ffich/MercurySystem/20_Output/30_Documentation/10_Datasheet/SB330_TemperatureBoard/Images/SB330_Hardware.png

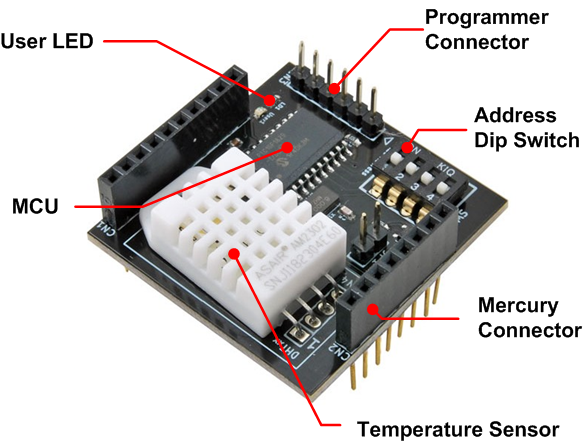
20_Output/30_Documentation/10_Datasheet/SB330_TemperatureBoard/Images/SB330_Hardware.png
