ffich/MercurySystem/10_Input/10_Specifiche/Mercury_MB310_ModemBt/Mercury_MB310_ModemBt_SpecificheTecniche.docx

Mercury System

Sistema modulare per applicazioni IoT

Modem Bluetooth (MB310)

Nome Cliente | Progetto | Major Rev | Minor Rev | Data
Internal | Mercury System – MB310 | 1 | 0 | 04/01/2017

Revisioni
Autore | Data | Major | Minor | Descrizione
Francesco Ficili | 04/01/2017 | 1 | 0 | Prima release.

# 1. Introduzione

Questo documento ha lo scopo di descrivere in dettaglio le specifiche relative alla scheda elettronica Mercury Modem BT, che costituisce una delle schede modem del “Mercury System”.

# 2. Schema a blocchi Hardware Base Board

In figura 2.1 è riportato lo schema a blocchi di principio del sistema. Il cuore del sistema è un modulo BT HC05.

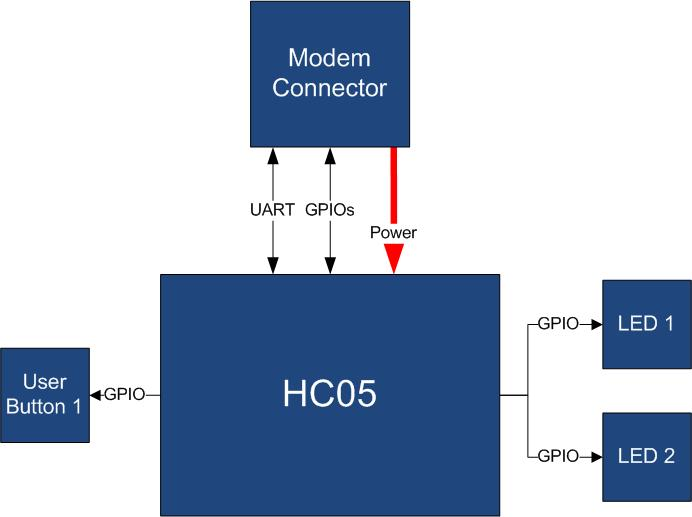
[picture p11: figure]

Figura 2.1 – Schema a blocchi hardware

I collegamenti in nero indicano collegamenti di segnale, i collegamenti in rosso indicano collegamenti di potenza.

Il modulo si interfaccia alla base board tramite il modem connector Mercury, che trasporta le linee di comunicazione e di alimentazione per il modem stesso.

La scheda è inoltre dotata di un pulsante collegato al pin KeyBt del modulo (con apposita resistenza di pull-up) e di due led di indicazione (pair e working).

# 3. Requisiti Hardware

Il sistema deve rispettare i requisiti hardware riportati in tabella 3.1

Requisito | Descrizione
MB310_HW_010 | Il connettore per la scheda modem da utilizzare è una strip a passo 2mm, 10x2.

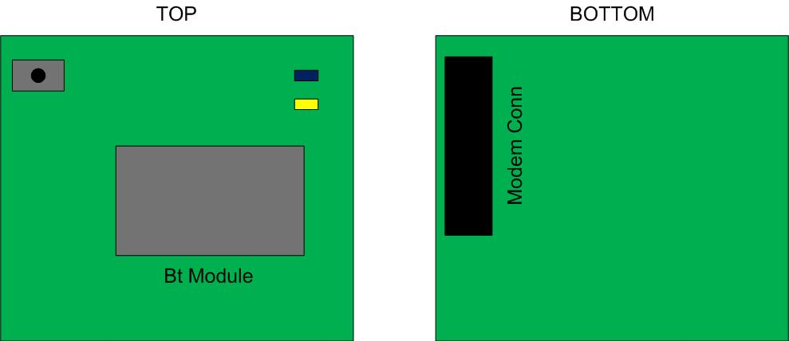
[picture p12: figure]

MB310_HW_020 | Il layout connettori della scheda è rappresentato nella figura in basso:
BB110_HW_030 | Le dimensioni indicative della scheda dovranno essere 38x32mm.

Tabell 3.1 – Requisiti Hardware

# 4. Power/Voltage Budget

In tabella 4.1 è riportato il voltage budget del sistema.

Componente | Operating Voltage Range [V]
Bt Module | 3.1 – 4.2

Tabella 4.1 – Voltage budget

In tabella 4.2 è riportato il power budget del sistema.

Componente | Low Power (e.g Sleep) | Typ. Power Cons. | Peak Power Cons.
Bt Module | 8mA | 8mA | 40mA

Tabella 4.2 – Power budget

Mercury System – Specifiche Tecniche
