ffich/MercurySystem/10_Input/10_Specifiche/Mercury_MB810_MbProtoA/Mercury_MB810_ModemProto_SpecificheTecniche.docx

Mercury System

Sistema modulare per applicazioni IoT

Modem Proto (MB810)

Nome Cliente | Progetto | Major Rev | Minor Rev | Data
Internal | Mercury System – MB810 | 1 | 0 | 06/01/2017

Revisioni
Autore | Data | Major | Minor | Descrizione
Francesco Ficili | 06/01/2017 | 1 | 0 | Prima release.

# 1. Introduzione

Questo documento ha lo scopo di descrivere in dettaglio le specifiche relative alla scheda elettronica Mercury Modem Proto, che costituisce una delle schede modem del “Mercury System”.

# 2. Schema a blocchi Hardware Base Board

In figura 2.1 è riportato lo schema a blocchi di principio del sistema.

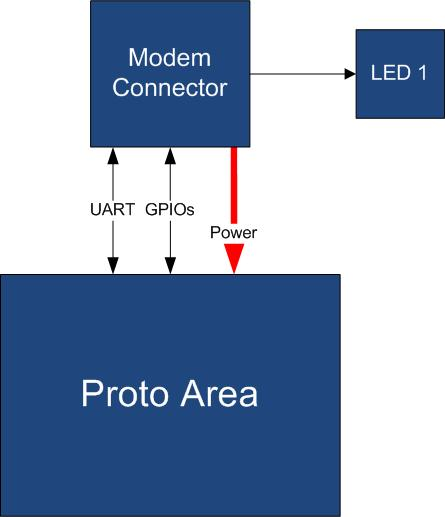
[picture p13: figure]

Figura 2.1 – Schema a blocchi hardware

I collegamenti in nero indicano collegamenti di segnale, i collegamenti in rosso indicano collegamenti di potenza.

Il modulo si interfaccia alla base board tramite il modem connector Mercury, che trasporta le linee di comunicazione e di alimentazione per il modem stesso.

# 3. Requisiti Hardware

Il sistema deve rispettare i requisiti hardware riportati in tabella 3.1

Requisito | Descrizione
MB810_HW_010 | Il connettore per la scheda modem da utilizzare è una strip a passo 2mm, 10x2.

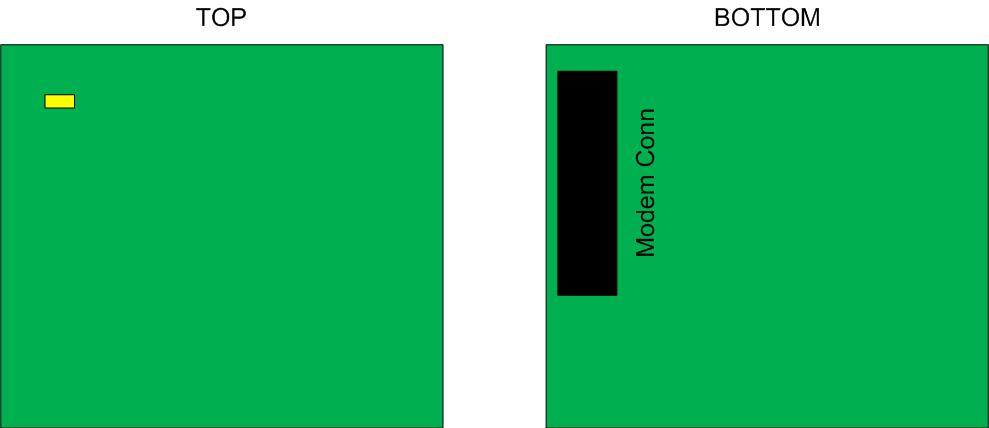
[picture p14: figure]

MB810_HW_020 | Il layout connettori della scheda è rappresentato nella figura in basso:
MB810_HW_030 | Le dimensioni indicative della scheda dovranno essere 38x32mm.

Tabell 3.1 – Requisiti Hardware

Mercury System – Specifiche Tecniche
