ffich/MercurySystem/10_Input/10_Specifiche/Mercury_SB110_RelayBoard/Mercury_SB110_RelayBoard_SpecificheTecniche.docx

Mercury System

Sistema modulare per applicazioni IoT

Relay Board (SB110)

Nome Cliente | Progetto | Major Rev | Minor Rev | Data
Internal | Mercury System – SB110 | 1 | 2 | 27/12/2015

Revisioni
Autore | Data | Major | Minor | Descrizione
Francesco Ficili | 27/12/2015 | 1 | 0 | Prima release.
Francesco Ficili | 29/05/2016 | 1 | 1 | Reworked.
Francesco Ficili | 31/12/2017 | 1 | 2 | Aggiunti requisiti SW e set di comandi.
Francesco Ficili | 12/01/2019 | 1 | 3 | Aggiunta variante con singolo relè da 10A.

# 1. Introduzione

Questo documento ha lo scopo di descrivere in dettaglio le specifiche relative alla scheda elettronica Mercury Relay Board, che costituisce una delle schede slave del “Mercury System”.

# 2. Schema a blocchi Hardware Relay Board

In figura 2.1 è riportato lo schema a blocchi di principio del sistema. Il cuore del sistema è un microcontrollore PIC16F1825, RISC a 8-bit, prodotto dalla Microchip Technology.

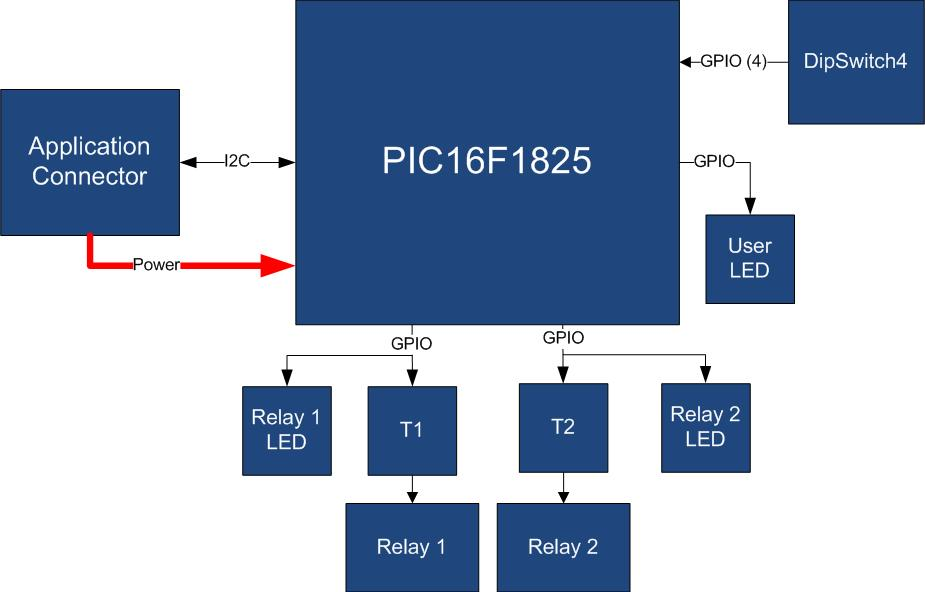
[picture p17: figure]

Figura 2.1 – Schema a blocchi hardware

I collegamenti in nero indicano collegamenti di segnale, i collegamenti in rosso indicano collegamenti di potenza.

La MCU utilizzata ha le seguenti caratteristiche (vedi Tabella 2.1).

Parameter Name | Value
Program Memory Type | Flash
Program Memory (KB) | 14
CPU Speed (MIPS) | 8
RAM Bytes | 1,024
Data EEPROM (bytes) | 256
Digital Communication Peripherals | 1-UART, 1-A/E/USART, 1-SPI, 1-I2C1-MSSP(SPI/I2C)
Capture/Compare/PWM Peripherals | 2 CCP, 2 ECCP
Timers | 4 x 8-bit, 1 x 16-bit
ADC | 8 ch, 10-bit
Comparators | 2
Temperature Range (C) | -40 to 125
Operating Voltage Range (V) | 1.8 to 5.5
Pin Count | 14
XLP | Yes
Cap Touch Channels | 12

Tabell 2.1 – Caratteristiche Hardware PIC16F1825

Il microcontrollore principale si interfaccia alla Mercury base board tramite l’application connector. Da questo connettore preleva l’alimentazione e si interfaccia al bus I2C, in modo da poter comunicare con la MCU della base board. La MCU è collegata tramite 4 linee di I/O ad un dipswitch a 4 posizioni, che permette di impostare l’indirizzo del nodo slave (nel caso di utilizzo di più di un nodo slave sulla rete I2C).

Il microcontrollore si interfaccia inoltre con 2 relè attraverso due linee di I/O.

La scheda dispone di una memoria non volatile EEPROM interna, per lo stoccaggio di parametri di configurazione.

# 3. Requisiti Hardware

Il sistema deve rispettare i requisiti hardware riportati in tabella 3.1

Requisito | Descrizione
SB110_HW_010 | Le uscite dei due relè devono essere implementate tramite due connettori jst a 3 poli (possibile variante con due morsettiere a 3 poli passo 2,54mm).
SB110_HW_020 | Il connettore per la scheda application è costituito da due connettori singoli a passo 2,54mm, 10x1 e 8x1 disposti ai lati del PCB.

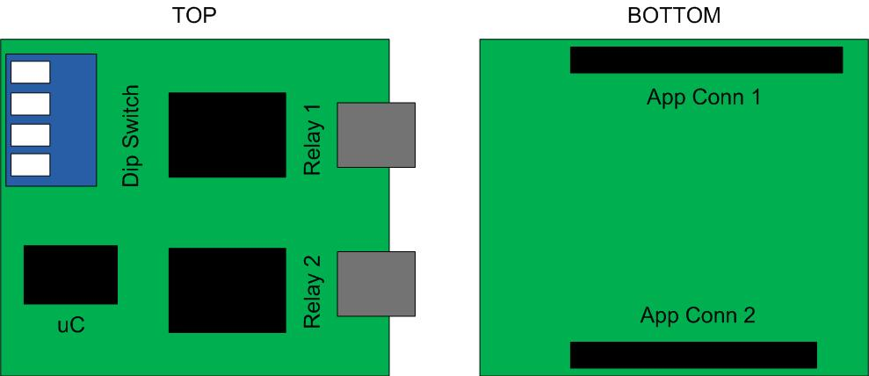
[picture p18: figure]

SB110_HW_030 | Il layout della scheda è rappresentato nella figura in basso:
SB110_HW_040 | Le dimensioni indicative della scheda dovranno essere 38x40mm.

Tabell 3.1 – Requisiti Hardware

# 4. Requisiti Software

Il sistema deve rispettare i requisiti funzionali riportati in tabella 4.1

Requisito | Descrizione
SB110_SW_010 | Il sw della scheda deve implementare il set di comandi standard per gli slave del sistema Mercury.
SB110_SW_020 | Il sw della scheda deve implementare il set di comandi dedicato, riportato al paragrafo 5.
SB110_SW_030 | Il sistema deve gestire il SW watchdog con periodo di 2s e rate di refresh di 100ms.

Tabella 4.1 – Requisiti Software

# 5. Command Set

Il sistema deve implementare il seguente set di comandi (tabella 5.1), specifico per la SB110.

Codice | Nome Cmd | Parametri | Descrizione
0x50 | Set relay status | Relay Sts (1 byte) | Setta lo stato dei relè della scheda. Lo stato è mappato come bitfield nel parametro Relay Sts (ogni bit rappresenta un relè, solo i primi due bit sono usati).
0x51 | Impulse relay 1 Seconds | Impulse len (2 byte) | Genera un impulso di durata pari al parametro per il relè 1 (il parametro Impulse len è in secondi).
0x52 | Impulse relay 2 Seconds | Impulse len (2 byte) | Genera un impulso di durata pari al parametro per il relè 2 (il parametro Impulse len è in secondi).
0x53 | Impulse both relay Seconds | Impulse len (2 byte) | Genera un impulso di durata pari al parametro per entrambi relè (il parametro Impulse len è in secondi).
0x60 | Request relay status | Nessuno | Richiede lo stato dei relè (questo comando prepara un byte che rappresenta lo stato dei relè come bitfield).

Tabella 5.1 – Command Set

# 6. Power/Voltage Budget

In tabella 6.1 è riportato il voltage budget del sistema:

Componente | Operating Voltage Range [V]
uC | 2.0 – 3.6 (regolato a 3.0)

Tabella 6.1 – Voltage budget

In tabella 6.2 è riportato il power budget del sistema:

Componente | Low Power (e.g Sleep) | Typ. Power Cons. | Peak Power Cons.
uC | 100nA | 10uA | 1mA

Tabella 6.2 – Power budget

# 7. Variante SB111

La SB111 è una variante del modello SB110 con singolo relè da 10A. Il modello di relè scelto per questa variante è il modello OMRON G5LA-14 da 5VDC. Anche la morsettiera dei contatti di uscita è da sostituire con un modello a passo 5,12mm.

Mercury System – Specifiche Tecniche
