ffich/MercurySystem/10_Input/10_Specifiche/Mercury_SB320_InfraredBoard/Mercury_SB320_InfraredBoard_SpecificheTecniche.docx

Mercury System

Sistema modulare per applicazioni IoT

Infrared Board (SB320)

Nome Cliente | Progetto | Major Rev | Minor Rev | Data
Internal | Mercury System – SB320 | 1 | 2 | 28/12/2015

Revisioni
Autore | Data | Major | Minor | Descrizione
Francesco Ficili | 28/12/2015 | 1 | 0 | Prima release.
Francesco Ficili | 29/05/2016 | 1 | 1 | Reworked.
Francesco Ficili | 03/01/2018 | 1 | 2 | Aggiunti requisiti SW e set di comandi.

# 1. Introduzione

Questo documento ha lo scopo di descrivere in dettaglio le specifiche relative alla scheda elettronica Mercury Infrared Board, che costituisce una delle schede slave del “Mercury System”.

# 2. Schema a blocchi Hardware Infrared Board

In figura 2.1 è riportato lo schema a blocchi di principio del sistema. Il cuore del sistema è un microcontrollore PIC16F1825, RISC a 8-bit, prodotto dalla Microchip Technology.

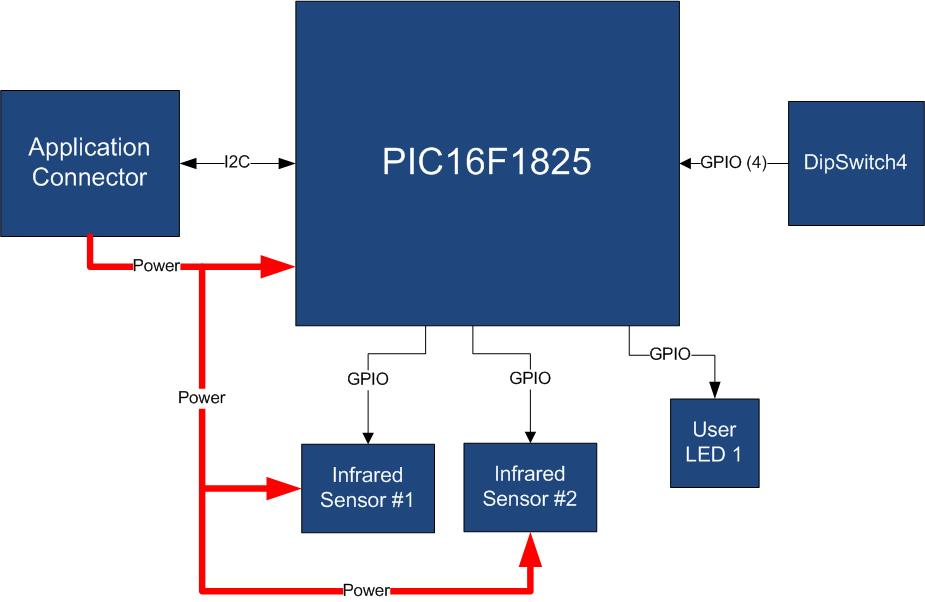
[picture p27: figure]

Figura 2.1 – Schema a blocchi hardware

I collegamenti in nero indicano collegamenti di segnale, i collegamenti in rosso indicano collegamenti di potenza.

La MCU utilizzata ha le seguenti caratteristiche (vedi Tabella 2.1).

Parameter Name | Value
Program Memory Type | Flash
Program Memory (KB) | 14
CPU Speed (MIPS) | 8
RAM Bytes | 1,024
Data EEPROM (bytes) | 256
Digital Communication Peripherals | 1-UART, 1-A/E/USART, 1-SPI, 1-I2C1-MSSP(SPI/I2C)
Capture/Compare/PWM Peripherals | 2 CCP, 2 ECCP
Timers | 4 x 8-bit, 1 x 16-bit
ADC | 8 ch, 10-bit
Comparators | 2
Temperature Range (C) | -40 to 125
Operating Voltage Range (V) | 1.8 to 5.5
Pin Count | 14
XLP | Yes
Cap Touch Channels | 12

Tabell 2.1 – Caratteristiche Hardware PIC16F1825

Il microcontrollore principale si interfaccia alla Mercury base board tramite l’application connector. Da questo connettore preleva l’alimentazione e si interfaccia al bus I2C, in modo da poter comunicare con la MCU della base board. La MCU è collegata tramite 4 linee di I/O ad un dipswitch a 4 posizioni, che permette di impostare l’indirizzo del nodo slave (nel caso di utilizzo di più di un nodo slave sulla rete I2C).

La scheda dispone di due connettori a 2 poli per l’interfacciamento con altrettanti sensori di distanta all’infrarosso, modello 8218-GP2Y0D810ZOF o 7300-GP2Y0D805PCB.

La scheda dispone di una memoria non volatile EEPROM interna, per lo stoccaggio di parametri di configurazione.

# 3. Requisiti Hardware

Il sistema deve rispettare i requisiti hardware riportati in tabella 3.1

Requisito | Descrizione
SB320_HW_010 | I connettori per i sensori all’infrarosso devono essere due coppie di strip femmina a 3 poli con inclinazione a 90°.
SB320_HW_020 | Il connettore per la scheda application è costituito da due connettori singoli a passo 2,54mm, 10x1 e 8x1 disposti ai lati del PCB.

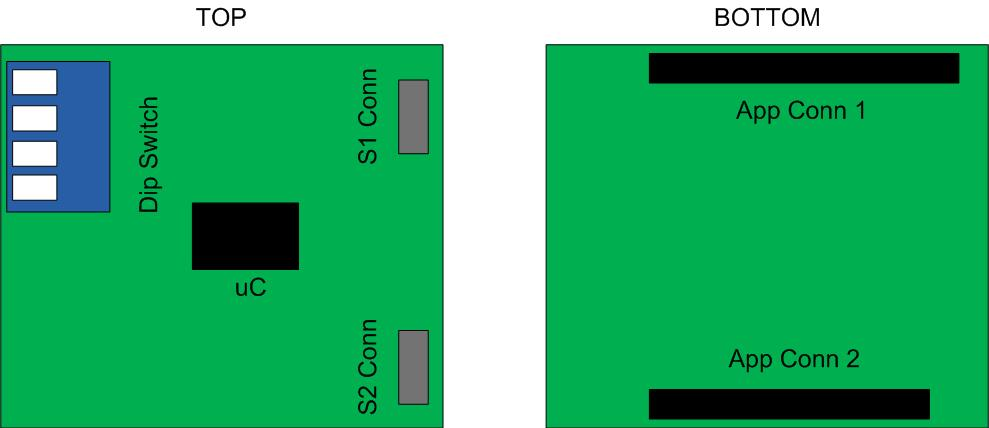
[picture p28: figure]

SB320_HW_030 | Il layout della scheda è rappresentato nella figura in basso:
SB320_HW_040 | Le dimensioni indicative della scheda dovranno essere 38x40mm.

Tabell 3.1 – Requisiti Hardware

# 4. Requisiti Software

Il sistema deve rispettare i requisiti funzionali riportati in tabella 4.1

Requisito | Descrizione
SB320_SW_010 | Il sw della scheda deve implementare il set di comandi standard per gli slave del sistema Mercury.
SB320_SW_020 | Il sw della scheda deve implementare il set di comandi dedicato, riportato al paragrafo 5.
SB320_SW_030 | Il sistema deve gestire il SW watchdog con periodo di 2s e rate di refresh di 100ms.

Tabell 4.1 – Requisiti Funzionali

# 5. Command Set

Il sistema deve implementare il seguente set di comandi (tabella 5.1), specifico per la SB110.

Codice | Nome Cmd | Parametri | Descrizione
0x60 | Request IR Sensors Status | Nessuno | Richiede lo stato dei due sensori IR. Questo comando prepara un byte che rappresenta lo stato dei due sensori come bitfield (solo i primi due bit sono utilizati).
0x61 | Request IR Sensors Status ASCII | Nessuno | Richiede la distanza in centimetri in formato ASCII (questo comando prepara due byte che rappresentano lo stato dei due sensori IR in formato ASCII).

Tabella 5.1 – Command Set

# 6. Power/Voltage Budget

In tabella 6.1 è riportato il voltage budget del sistema:

Componente | Operating Voltage Range [V]
uC | 2.0 – 3.6 (regolato a 3.0)
Infrared Sensor | 2,7 – 6,2 (regolato a 3.0)

Tabella 6.1 – Voltage budget

In tabella 6.2 è riportato il power budget del sistema:

Componente | Low Power (e.g Sleep) | Typ. Power Cons. | Peak Power Cons.
uC | 100nA | 10uA | 1mA
Infrared Sensor | 5mA | 5mA | 5mA

Tabella 6.2 – Power budget

Mercury System – Specifiche Tecniche
