ffich/MercurySystem/20_Output/30_Documentation/40_ProductPages/EB210_ExpansionLCD16x2/MS_EB210_ProductPage.docx

# 1. Mercury System EB210 – LCD 16x2 Expansion Board

The EB210 is a Mercury System expansion board with integrated alphanumeric 16x2 display. The board allows the classic planar expansion offered by Mercury System expansion board, and at the same time provides a way to build a simple User Interface. Figure 1 shows the EB210 block diagram. The heart of the system is a PIC16F1829 8-bit RISC microcontroller, produced by Microchip Technology Inc.

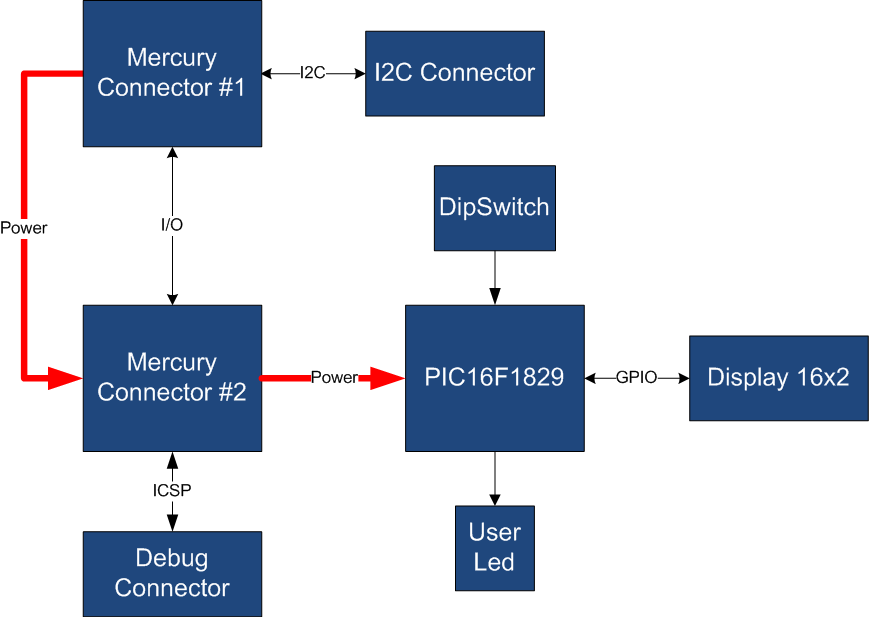
[picture p59: figure]

Figure 1 - Block Diagram

The main characteristics of the employed MCU are resumed in Table 1:

Table 1 - MCU characteristics

Parameter Name | Description
Program Memory Type | Flash
Program Memory (KB) | 14
CPU Speed (MIPS) | 8
RAM Bytes | 1,024
Data EEPROM (bytes) | 256
Digital Communication Peripherals | 1-UART, 1-A/E/USART, 1-SPI, 1-I2C1-MSSP(SPI/I2C)
Capture/Compare/PWM Peripherals | 2 CCP, 2 ECCP
Timers | 4 x 8-bit, 1 x 16-bit
ADC | 12 ch, 10-bit
Comparators | 2
Temperature Range (C) | -40 to 125
Operating Voltage Range (V) | 1.8 to 5.5
Pin Count | 20
XLP | Yes

The EB210 is connected to the BB by means of I2C bus. The address of the board could be dynamically set by means of a 4 positions dip switch, allowing up to 15 address values (address 0x00 is reserved for I2C general call broadcast addressing scheme).

Table 2 resumes the EB210 board main characteristics:

Table 2 – Board Characteristics

Parameter | Description | Notes
Board Type | Expansion Board (EB)
Supported Bus | I2C
Addressing | Dip Switch 4
Peripheral Description | Alphanumeric 16x2 LCD Display

Figure 2 depicts the most important components of the board:

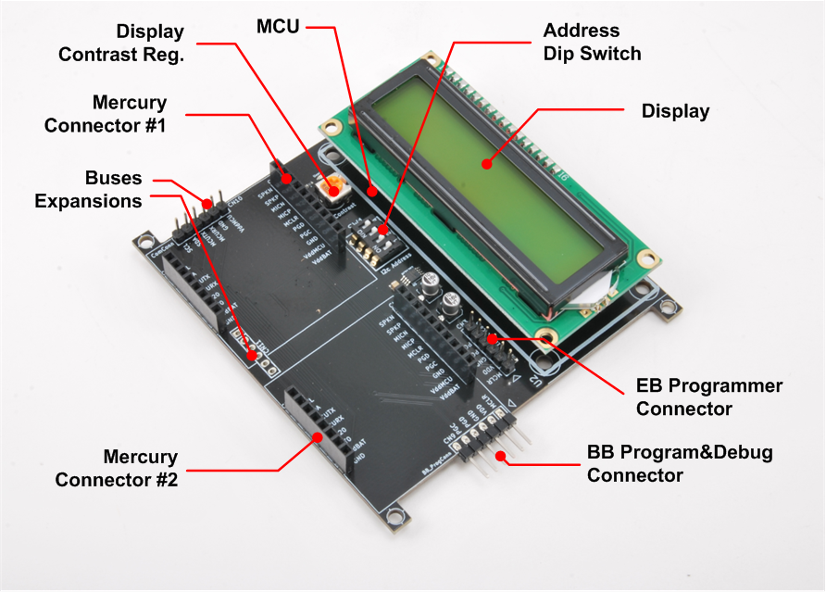
[picture p60: figure]

Figure 2 - Hardware Highlight

Table 3 provides a description of board’s main components:

Table 3 – Hardware characteristics

Name | Description
Mercury Connectors #1 and #2 | Mercury connector used to interface the board with the others MS boards.
Address Dip Switch | Dip Switch to set the address of the board within the Mercury System.
MCU | PIC16F1829 main controller board.
EB Programmer Connector | PicKit 3 Microchip Programmer/debugger connector. It is directly connected to the EB (Expansion Board) MCU debug port, in order to allow advanced debugging and programming features, if needed.
BB Program&Debug Connector | PicKit 3 Microchip Programmer/debugger connector. It is directly connected to the BB (Base Board) MCU debug port, in order to allow advanced debugging and programming features, if needed.
Display | 16x2 Alphanumeric LCD Display.
Display Contrast Reg. | Potentiometer for display contrast regulation.
Buses Expansion | Expansions connectors that carry power as well as I2C and UART connection.
