ffich/MercurySystem/10_Input/10_Specifiche/Mercury_System/MERCURY_Microcontroller_BoardCrossReference.xlsx

Mercury Board | Description | Microcontroller
BB110 | Main Board | PIC18F46J50
SB110 | Relay Board | PIC16F1825
SB120 | Neopixel Board | PIC16F1829
SB130 | Servo Board | PIC16F1829
SB140 | HSD Board | PIC16F1829
SB310 | Ultrasonic Board | PIC16F1829
SB320 | Infrared Board | PIC16F1825
SB330 | Temperature Board | PIC16F1829
SB340 | Accel Board | PIC16F1829
SB810 | Proto Board | PIC16F1829
EB210 | Expansion LCD 16x2 Board | PIC16F1829
MB210, MB310, MB810, EB110, EB111 | Modems and generic expansions | No Micro
