ffich/MercurySystem/20_Output/20_SwProjects/10_trunk/10_BaseBoards/Bootloader/BootFwk/BootOptions.docx

Bootloader Options

XC8 Linker\Memory Model --> ROM Ranges: default,-0-1FFF,-2006-2007,-2016-2017,-EFFF-FFFF

XC8 Linker\Additional Options --> CodeOffset: 0x2000

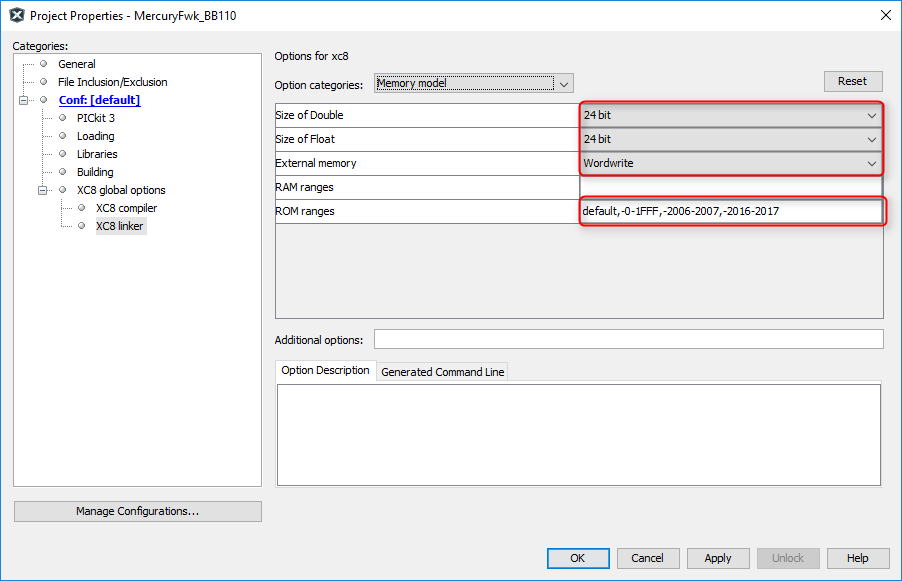
[picture p88: figure]
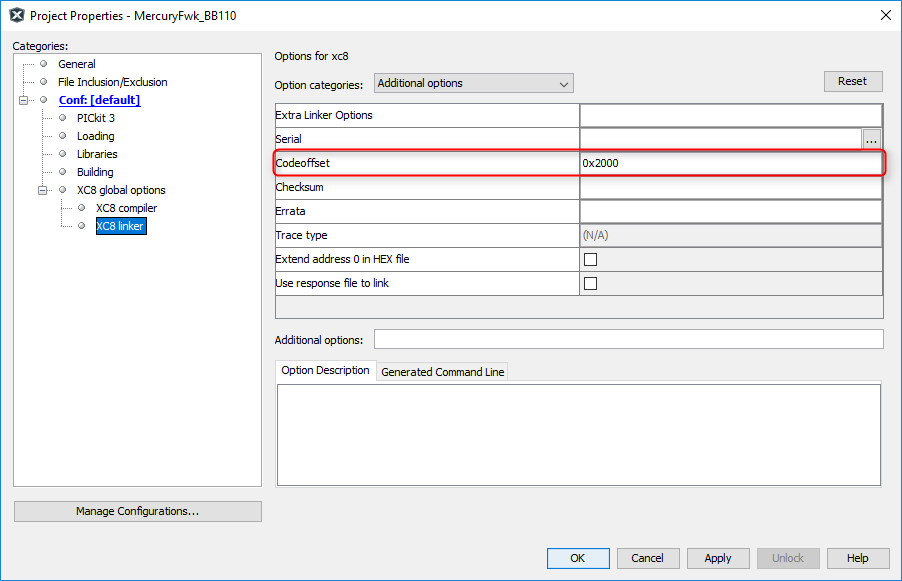
[picture p89: figure]
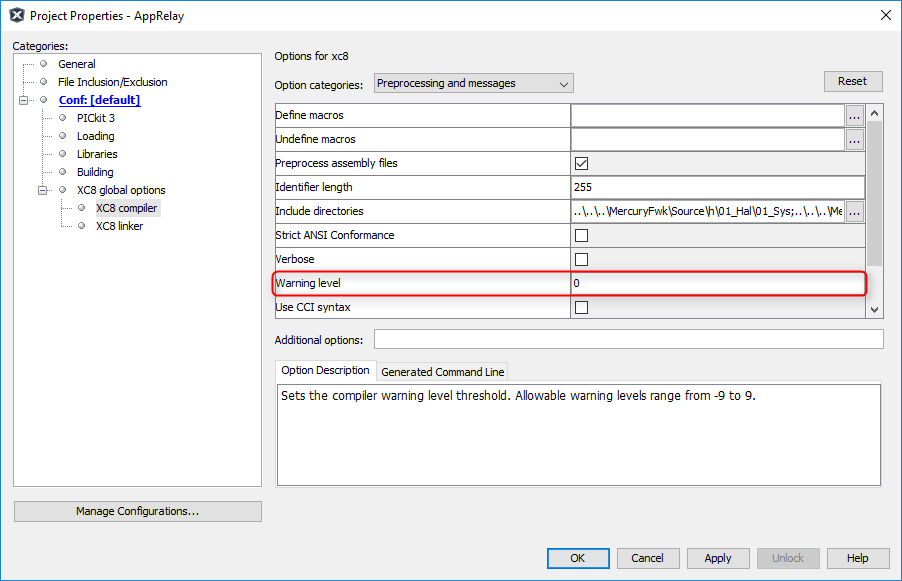
[picture p90: figure]
