ffich/MercurySystem/10_Input/10_Specifiche/Mercury_BB110_BaseBoardModelA/Schemi a blocchi/LayoutExpansionBoard - 4.jpg

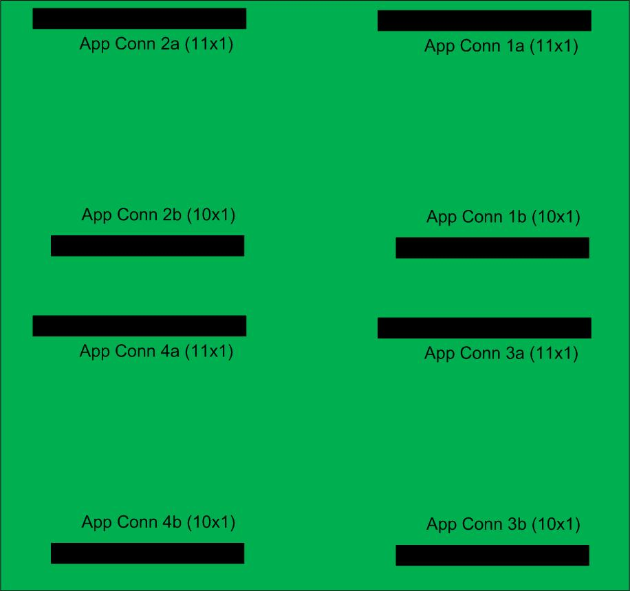
10_Input/10_Specifiche/Mercury_BB110_BaseBoardModelA/Schemi a blocchi/LayoutExpansionBoard - 4.jpg
