ffich/MercurySystem/10_Input/10_Specifiche/Mercury_MB210_ModemWiFi/Schemi a blocchi/ModemConnector.jpg

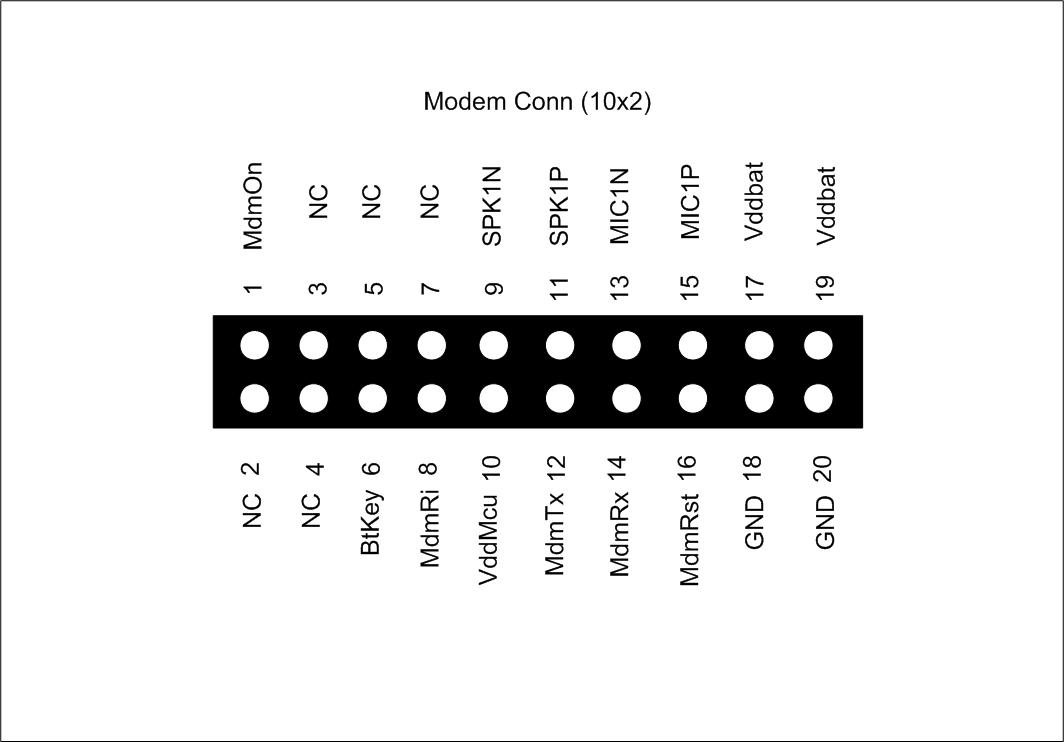
10_Input/10_Specifiche/Mercury_MB210_ModemWiFi/Schemi a blocchi/ModemConnector.jpg
