ffich/MercurySystem/10_Input/10_Specifiche/Mercury_SB330_TemperatureBoard/Schemi a blocchi/MsgTempHum.jpg

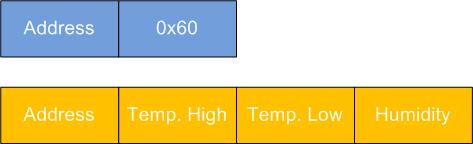
10_Input/10_Specifiche/Mercury_SB330_TemperatureBoard/Schemi a blocchi/MsgTempHum.jpg
