ffich/MercurySystem/10_Input/10_Specifiche/Mercury_System/Immagini/Esempio_BaseBoard.jpg

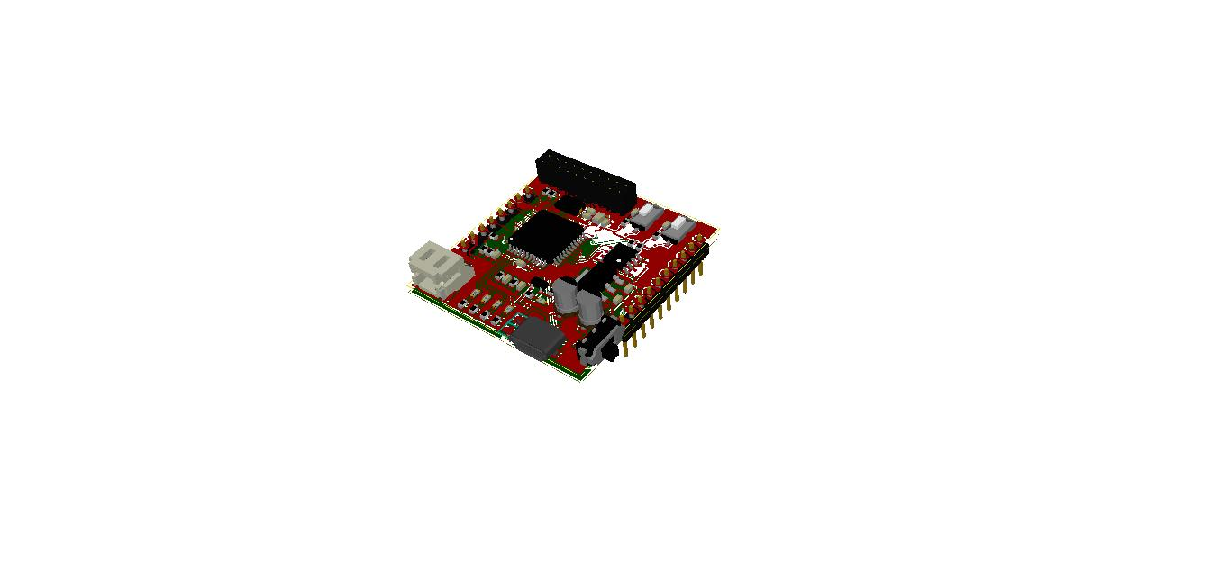
10_Input/10_Specifiche/Mercury_System/Immagini/Esempio_BaseBoard.jpg
