ffich/MercurySystem/20_Output/30_Documentation/10_Datasheet/BB110_BaseBoardPic18F/Images/BB110_3_main-500x500.jpg

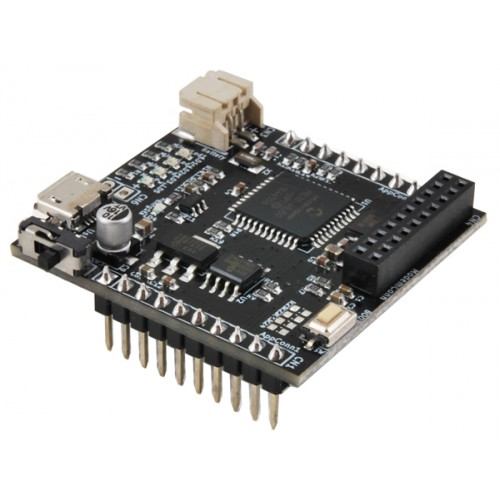
20_Output/30_Documentation/10_Datasheet/BB110_BaseBoardPic18F/Images/BB110_3_main-500x500.jpg
