ffich/MercurySystem/20_Output/30_Documentation/10_Datasheet/BB110_BaseBoardPic18F/Images/BB110_ModemConn.png

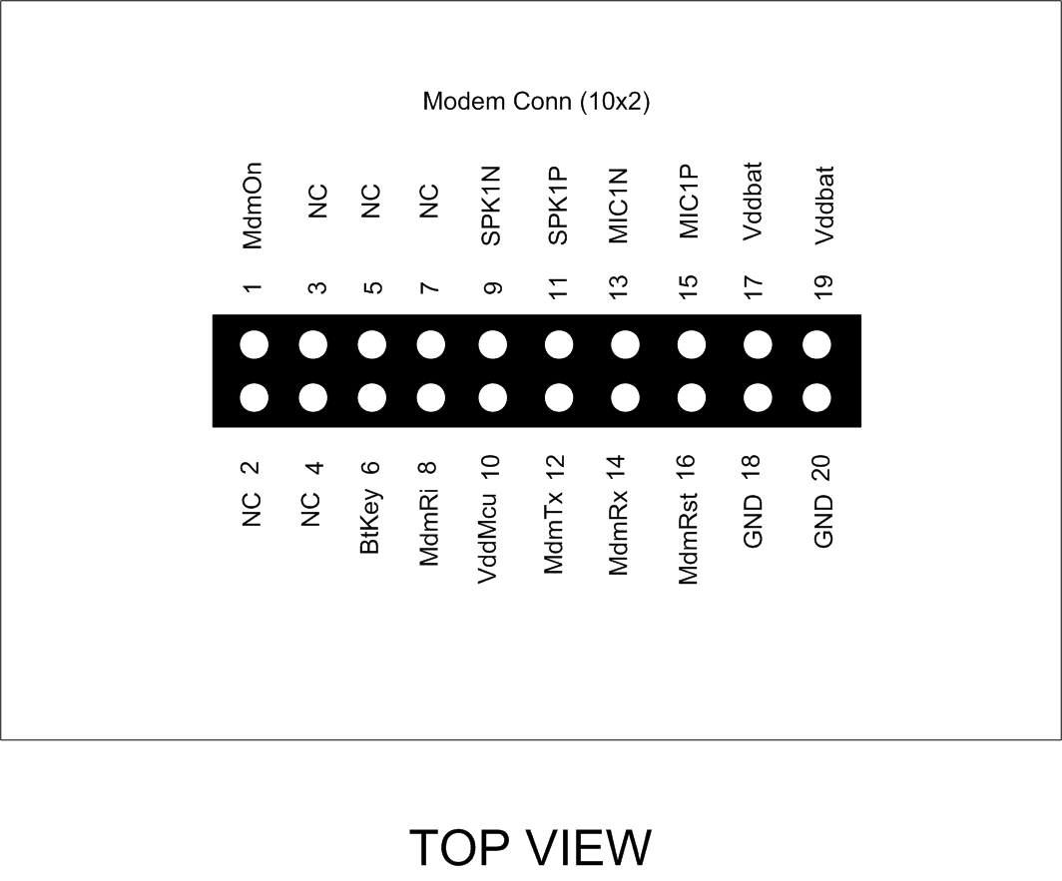
20_Output/30_Documentation/10_Datasheet/BB110_BaseBoardPic18F/Images/BB110_ModemConn.png
