ffich/MercurySystem/20_Output/30_Documentation/10_Datasheet/BL810_BrainlessProto/Images/front.png

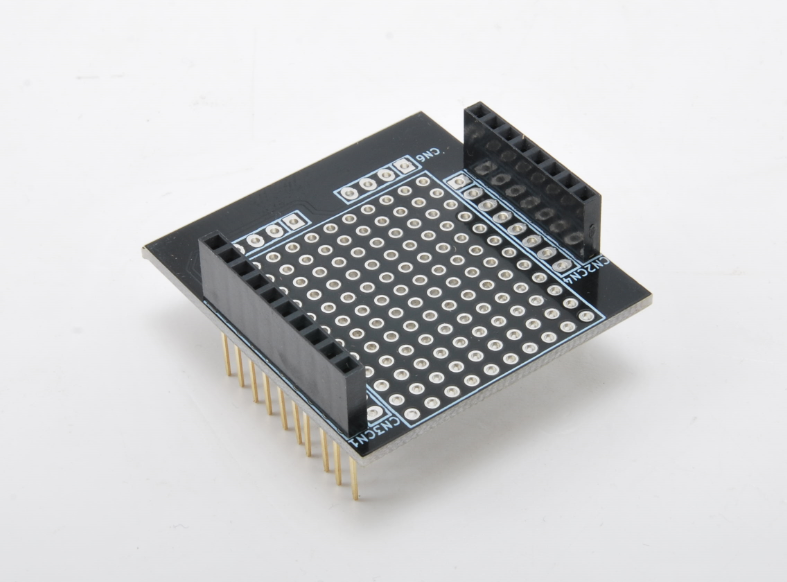
20_Output/30_Documentation/10_Datasheet/BL810_BrainlessProto/Images/front.png
