ffich/MercurySystem/20_Output/30_Documentation/10_Datasheet/EB110_ExpansionDual/Images/EB110_4_main-500x500.jpg

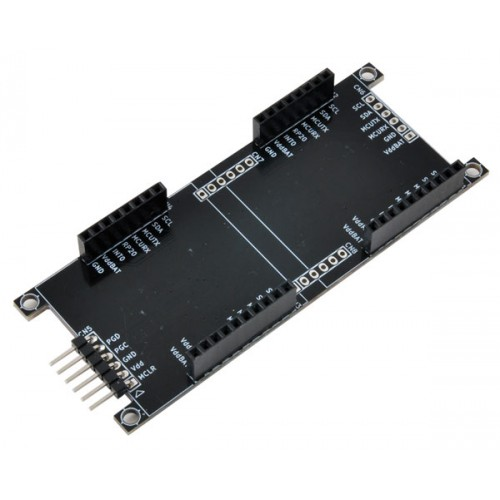
20_Output/30_Documentation/10_Datasheet/EB110_ExpansionDual/Images/EB110_4_main-500x500.jpg
