ffich/MercurySystem/20_Output/30_Documentation/10_Datasheet/EB110_ExpansionDual/Images/EB110_BBProgConn.png

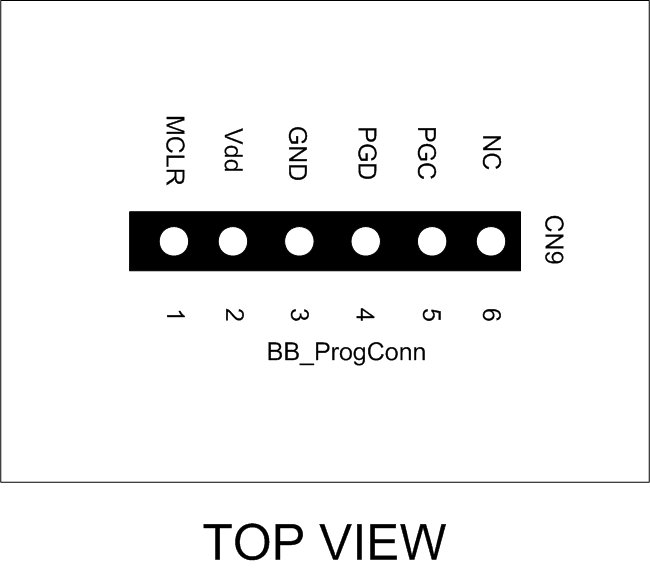
20_Output/30_Documentation/10_Datasheet/EB110_ExpansionDual/Images/EB110_BBProgConn.png
