ffich/MercurySystem/20_Output/30_Documentation/10_Datasheet/EB111_ExpansionQuad/Images/EB111_Front.png

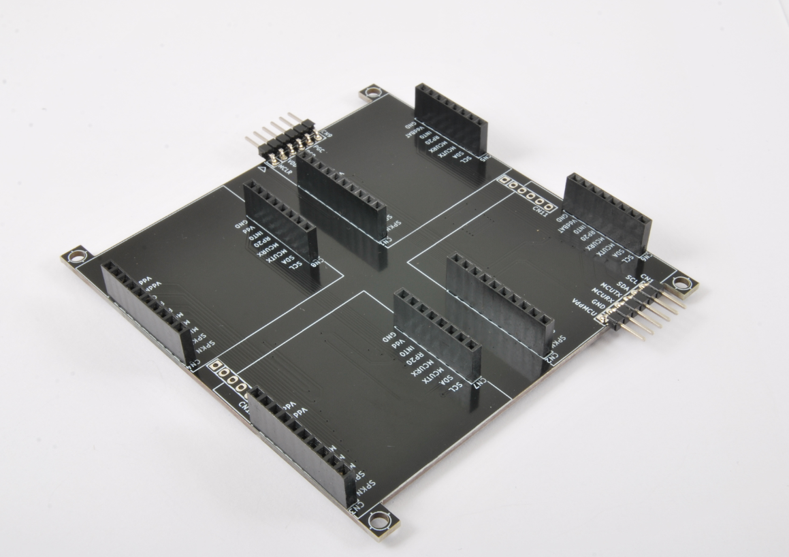
20_Output/30_Documentation/10_Datasheet/EB111_ExpansionQuad/Images/EB111_Front.png
