ffich/MercurySystem/20_Output/30_Documentation/10_Datasheet/EB111_ExpansionQuad/Images/EB111_main-228x228.jpg

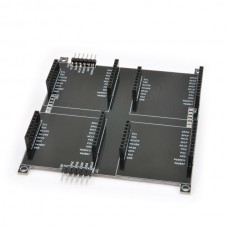
20_Output/30_Documentation/10_Datasheet/EB111_ExpansionQuad/Images/EB111_main-228x228.jpg
