ffich/MercurySystem/20_Output/30_Documentation/10_Datasheet/EB111_ExpansionQuad/Images/HW.png

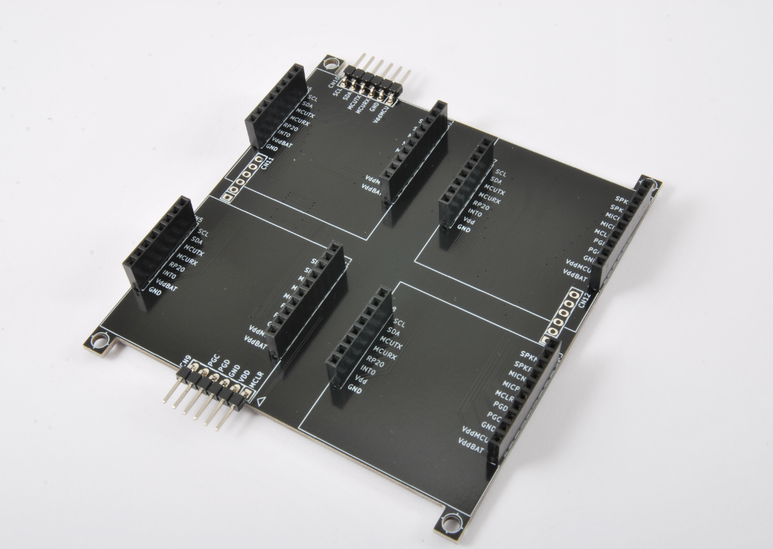
20_Output/30_Documentation/10_Datasheet/EB111_ExpansionQuad/Images/HW.png
