ffich/MercurySystem/20_Output/30_Documentation/10_Datasheet/EB210_ExpansionLCD16x2/Images/EB210-2_main-228x228.jpg

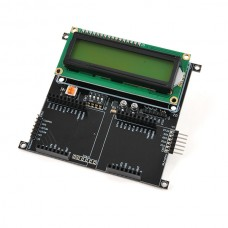
20_Output/30_Documentation/10_Datasheet/EB210_ExpansionLCD16x2/Images/EB210-2_main-228x228.jpg
