ffich/MercurySystem/20_Output/30_Documentation/10_Datasheet/EB210_ExpansionLCD16x2/Images/EB210_Front.png

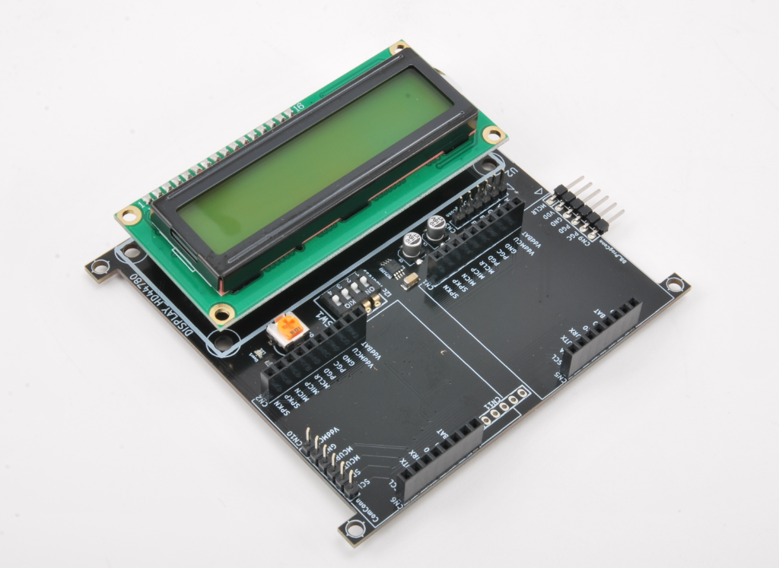
20_Output/30_Documentation/10_Datasheet/EB210_ExpansionLCD16x2/Images/EB210_Front.png
