ffich/MercurySystem/20_Output/30_Documentation/10_Datasheet/MB210_WifiModemBoard/Images/MB201_Hardware.png

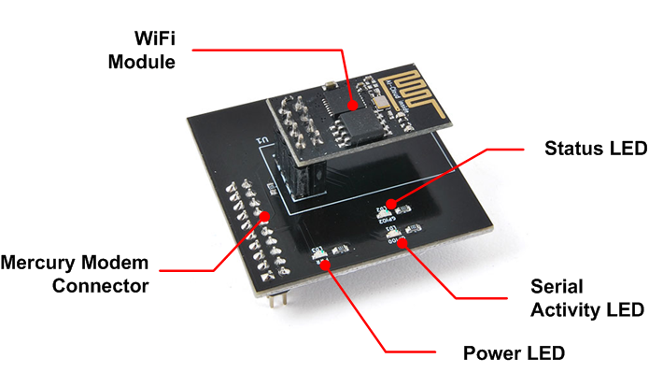
20_Output/30_Documentation/10_Datasheet/MB210_WifiModemBoard/Images/MB201_Hardware.png
