ffich/MercurySystem/20_Output/30_Documentation/10_Datasheet/MB210_WifiModemBoard/Images/ModemConnector.png

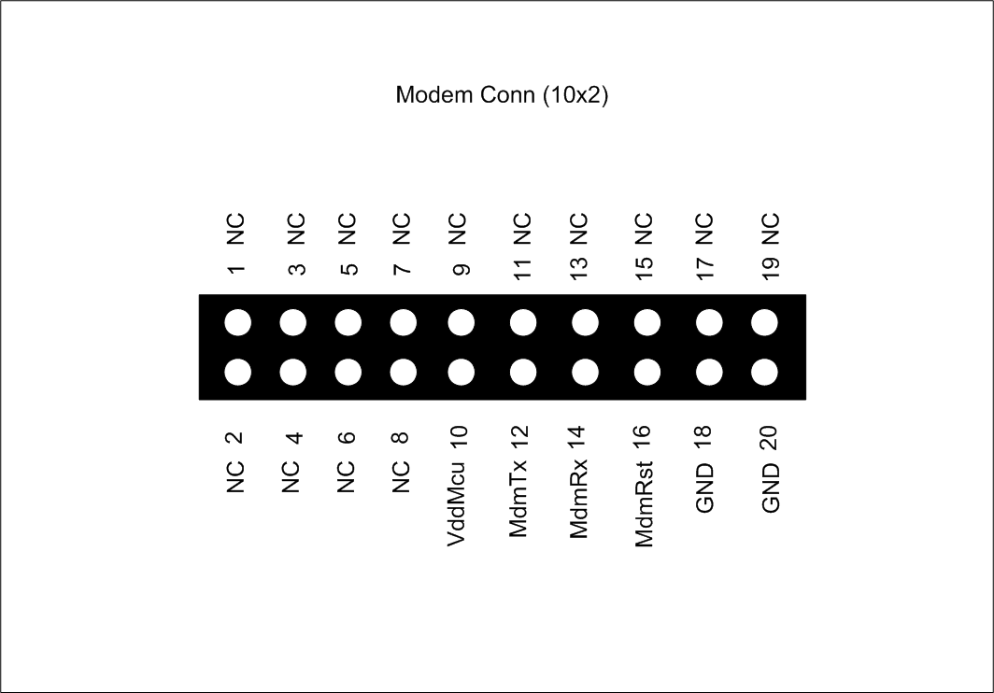
20_Output/30_Documentation/10_Datasheet/MB210_WifiModemBoard/Images/ModemConnector.png
