ffich/MercurySystem/20_Output/30_Documentation/10_Datasheet/MB310_BtModemBoard/Images/Front.png

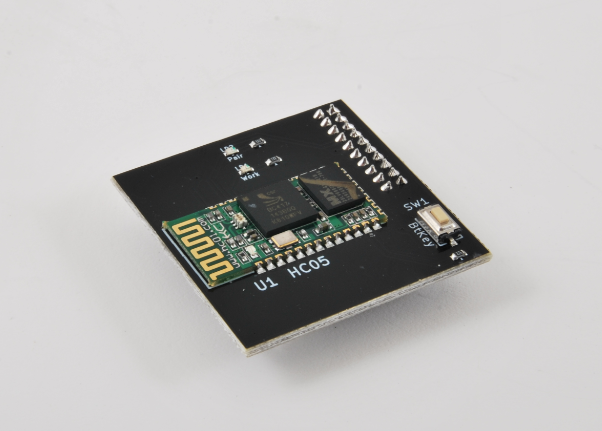
20_Output/30_Documentation/10_Datasheet/MB310_BtModemBoard/Images/Front.png
