ffich/MercurySystem/20_Output/30_Documentation/10_Datasheet/MB310_BtModemBoard/Images/HW.png

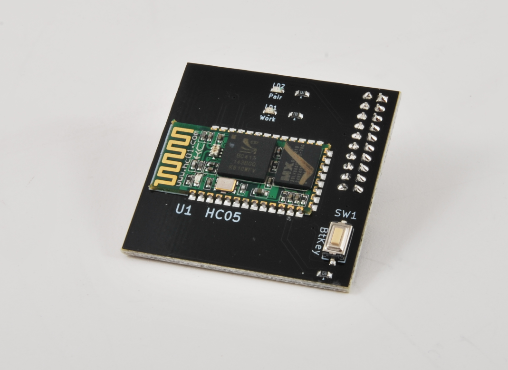
20_Output/30_Documentation/10_Datasheet/MB310_BtModemBoard/Images/HW.png
