ffich/MercurySystem/20_Output/30_Documentation/10_Datasheet/MB310_BtModemBoard/Images/MB310_main-500x500.jpg

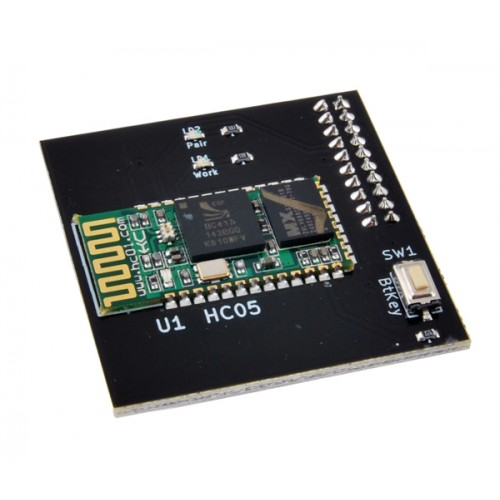
20_Output/30_Documentation/10_Datasheet/MB310_BtModemBoard/Images/MB310_main-500x500.jpg
