ffich/MercurySystem/20_Output/30_Documentation/10_Datasheet/MB810_ModemProto/Images/SchemaHardware.png

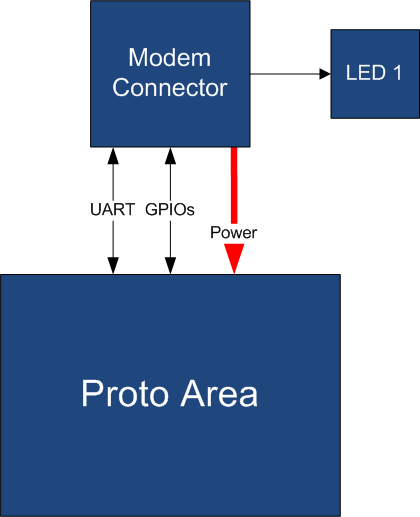
20_Output/30_Documentation/10_Datasheet/MB810_ModemProto/Images/SchemaHardware.png
