ffich/MercurySystem/20_Output/30_Documentation/10_Datasheet/PB110_PowerBoard12V1A/Images/front.png

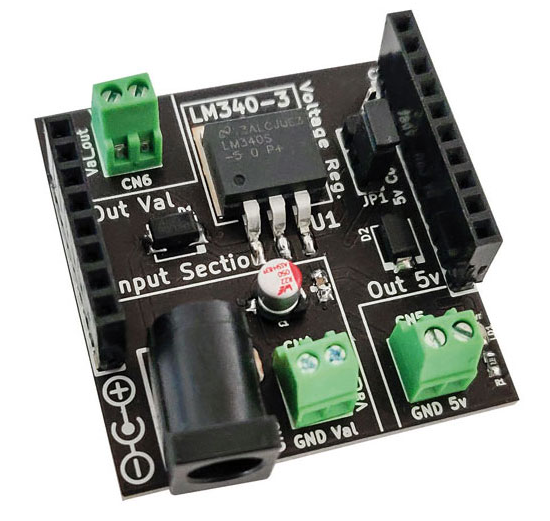
20_Output/30_Documentation/10_Datasheet/PB110_PowerBoard12V1A/Images/front.png
