ffich/MercurySystem/20_Output/30_Documentation/10_Datasheet/SB110_RelayBoard/Images/Front.png

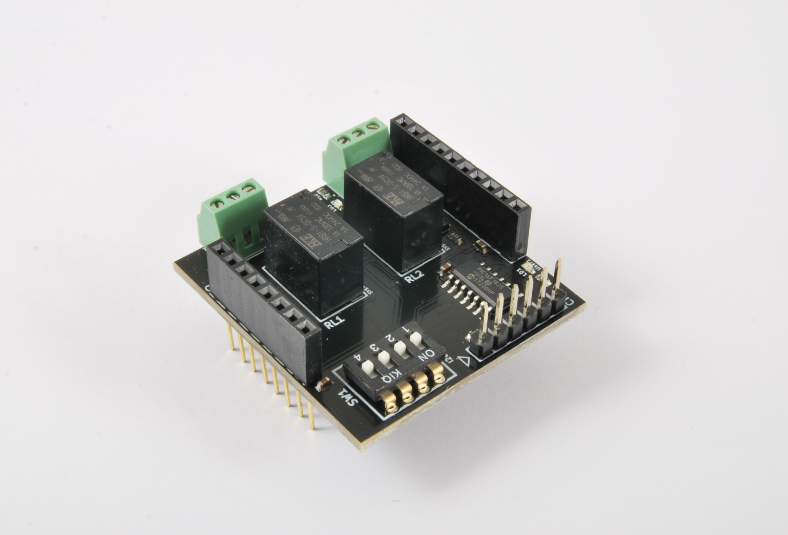
20_Output/30_Documentation/10_Datasheet/SB110_RelayBoard/Images/Front.png
