ffich/MercurySystem/20_Output/30_Documentation/10_Datasheet/SB110_RelayBoard/Images/SB110_1_main-500x500.jpg

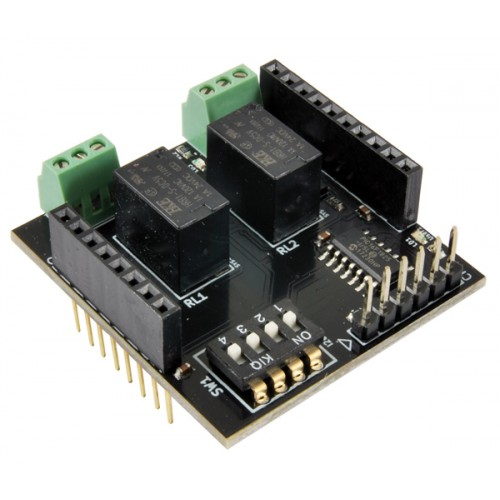
20_Output/30_Documentation/10_Datasheet/SB110_RelayBoard/Images/SB110_1_main-500x500.jpg
