ffich/MercurySystem/20_Output/30_Documentation/10_Datasheet/SB110_RelayBoard/Images/SB110_RelayConn.jpg

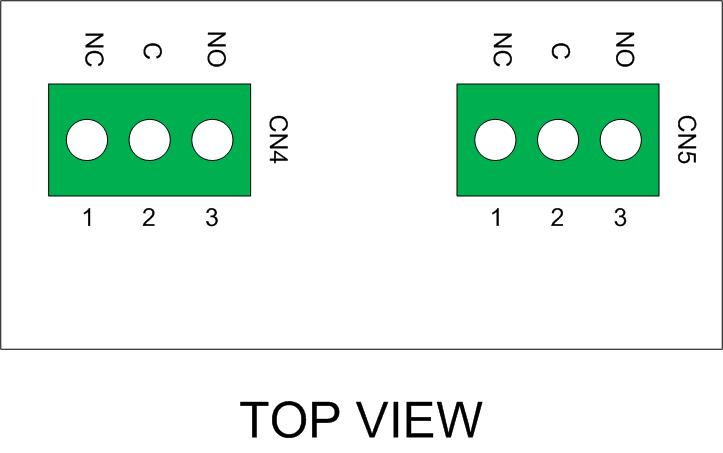
20_Output/30_Documentation/10_Datasheet/SB110_RelayBoard/Images/SB110_RelayConn.jpg
