ffich/MercurySystem/20_Output/30_Documentation/10_Datasheet/SB111_BigRelayBoard/Images/front.png

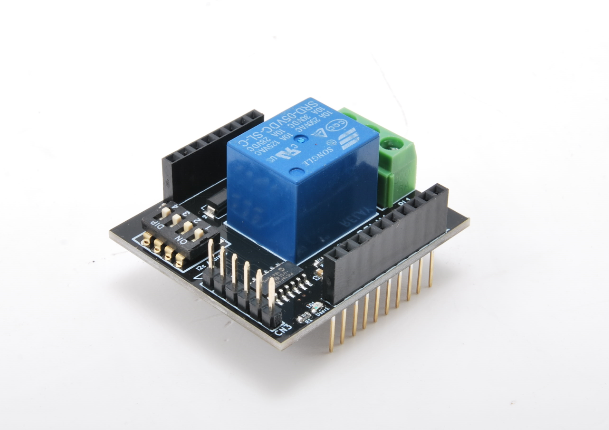
20_Output/30_Documentation/10_Datasheet/SB111_BigRelayBoard/Images/front.png
