ffich/MercurySystem/20_Output/30_Documentation/10_Datasheet/SB111_BigRelayBoard/Images/SB111Conn.png

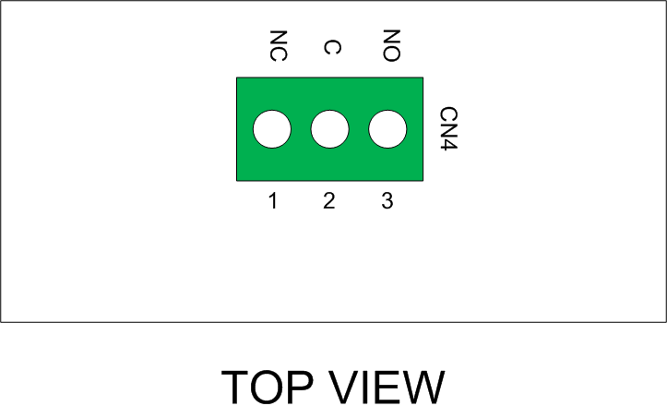
20_Output/30_Documentation/10_Datasheet/SB111_BigRelayBoard/Images/SB111Conn.png
