ffich/MercurySystem/20_Output/30_Documentation/10_Datasheet/SB120_NeopixelBoard/Images/HW.png

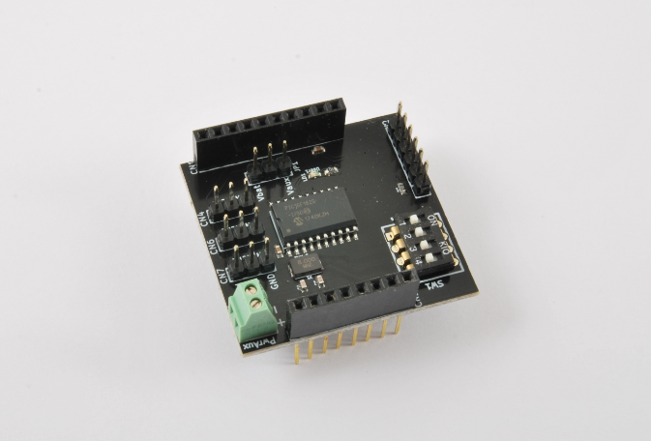
20_Output/30_Documentation/10_Datasheet/SB120_NeopixelBoard/Images/HW.png
