ffich/MercurySystem/20_Output/30_Documentation/10_Datasheet/SB120_NeopixelBoard/Images/SB120-2_main-500x500.jpg

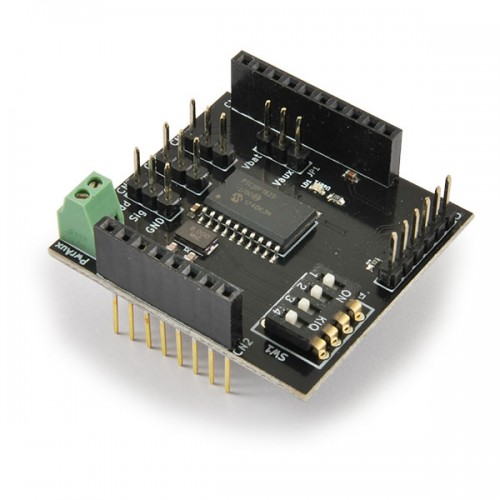
20_Output/30_Documentation/10_Datasheet/SB120_NeopixelBoard/Images/SB120-2_main-500x500.jpg
