ffich/MercurySystem/20_Output/30_Documentation/10_Datasheet/SB120_NeopixelBoard/Images/SB120_Front.png

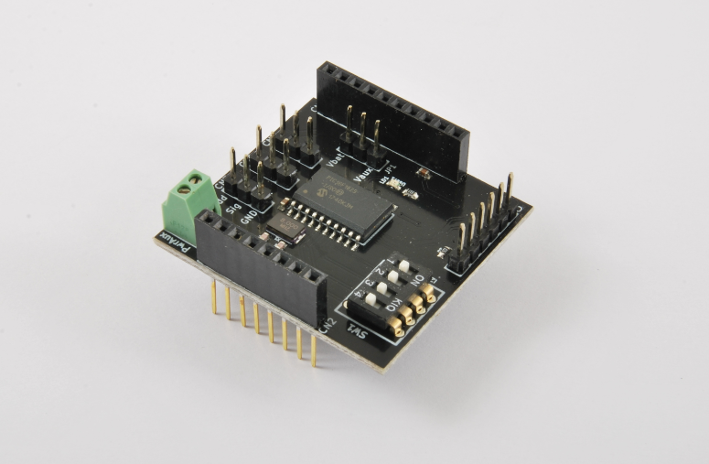
20_Output/30_Documentation/10_Datasheet/SB120_NeopixelBoard/Images/SB120_Front.png
