ffich/MercurySystem/20_Output/30_Documentation/10_Datasheet/SB130_ServoBoard/Images/HW.png

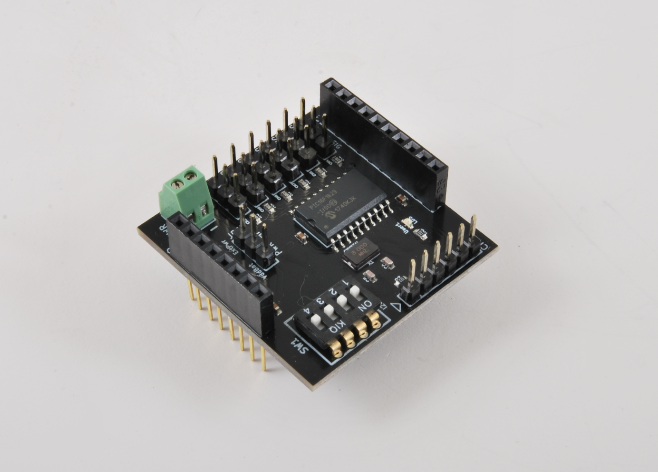
20_Output/30_Documentation/10_Datasheet/SB130_ServoBoard/Images/HW.png
