ffich/MercurySystem/20_Output/30_Documentation/10_Datasheet/SB130_ServoBoard/Images/SB130_main-500x500.jpg

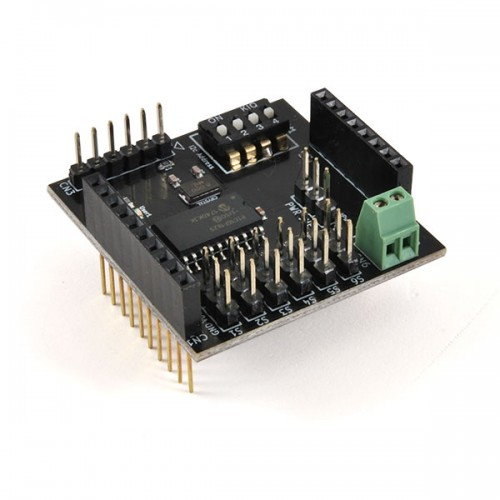
20_Output/30_Documentation/10_Datasheet/SB130_ServoBoard/Images/SB130_main-500x500.jpg
