ffich/MercurySystem/20_Output/30_Documentation/10_Datasheet/SB130_ServoBoard/Images/SB130_ServoConn.png

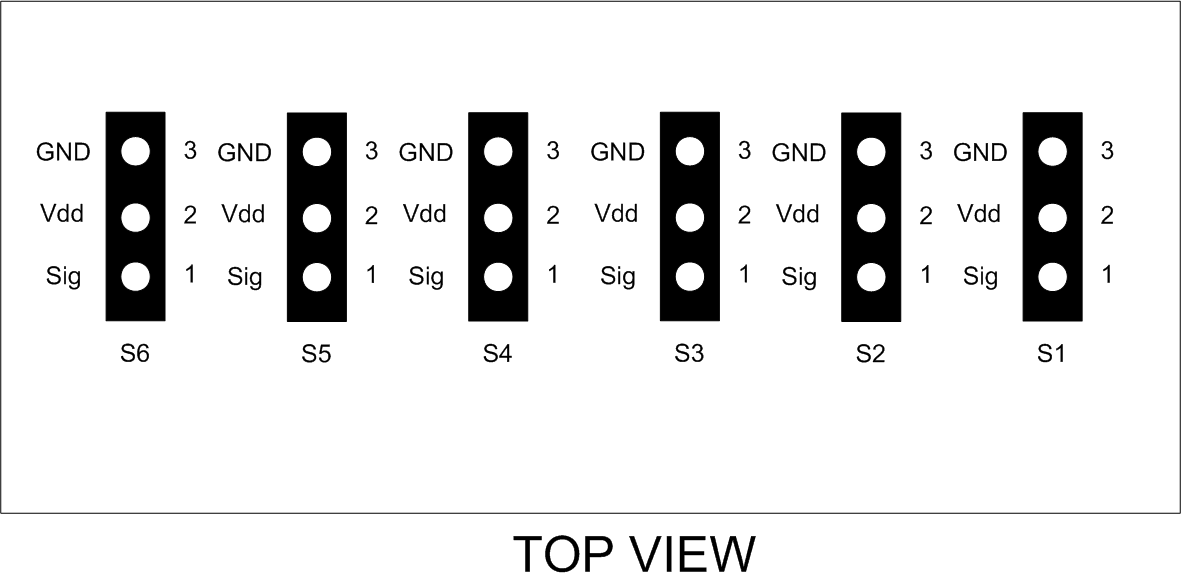
20_Output/30_Documentation/10_Datasheet/SB130_ServoBoard/Images/SB130_ServoConn.png
