ffich/MercurySystem/20_Output/30_Documentation/10_Datasheet/SB140_HSDBoard/Images/HW.png

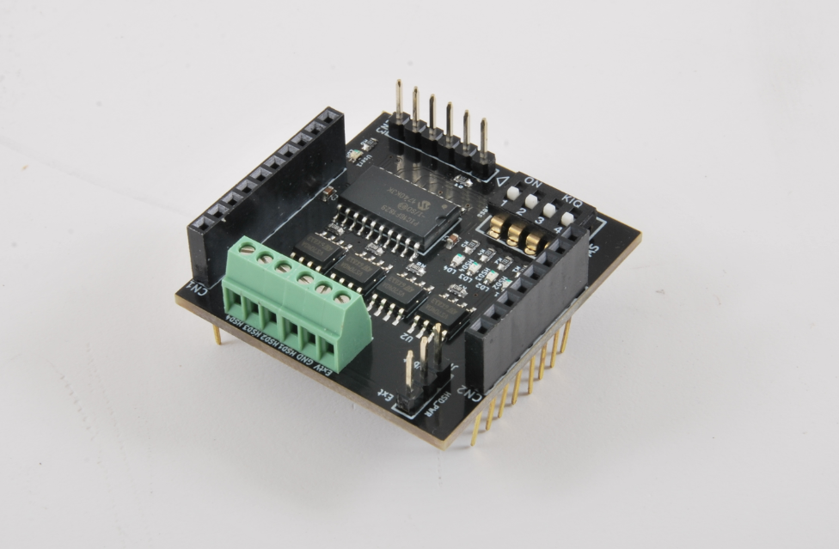
20_Output/30_Documentation/10_Datasheet/SB140_HSDBoard/Images/HW.png
