ffich/MercurySystem/20_Output/30_Documentation/10_Datasheet/SB140_HSDBoard/Images/SB140_HsdOutConn.png

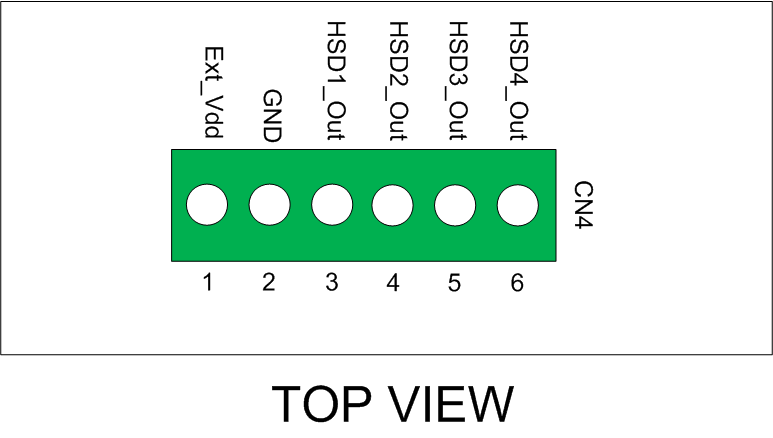
20_Output/30_Documentation/10_Datasheet/SB140_HSDBoard/Images/SB140_HsdOutConn.png
