ffich/MercurySystem/20_Output/30_Documentation/10_Datasheet/SB140_HSDBoard/Images/SB140_main-500x500.jpg

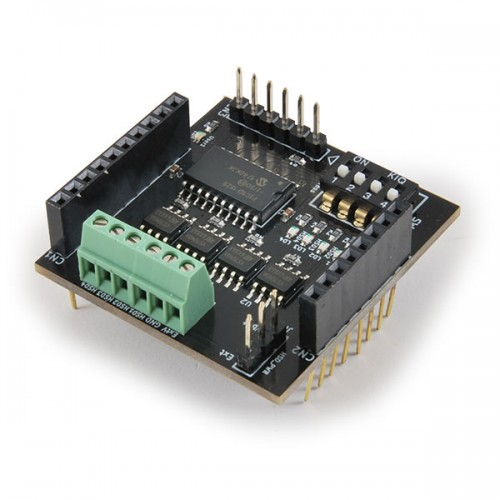
20_Output/30_Documentation/10_Datasheet/SB140_HSDBoard/Images/SB140_main-500x500.jpg
