ffich/MercurySystem/20_Output/30_Documentation/10_Datasheet/SB310_UltrasonicBoard/Images/SB310_main-500x500.jpg

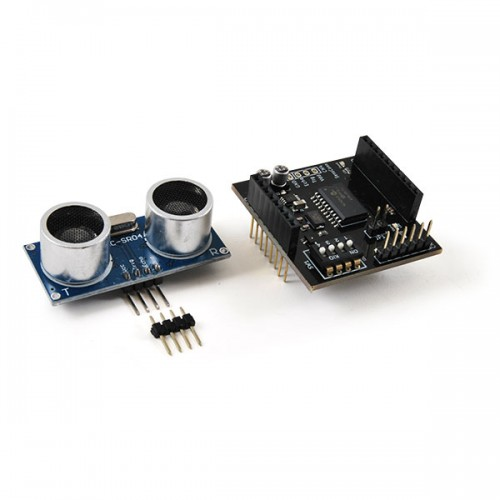
20_Output/30_Documentation/10_Datasheet/SB310_UltrasonicBoard/Images/SB310_main-500x500.jpg
