ffich/MercurySystem/20_Output/30_Documentation/10_Datasheet/SB320_InfraredBoard/Images/SB320-2_main-500x500.jpg

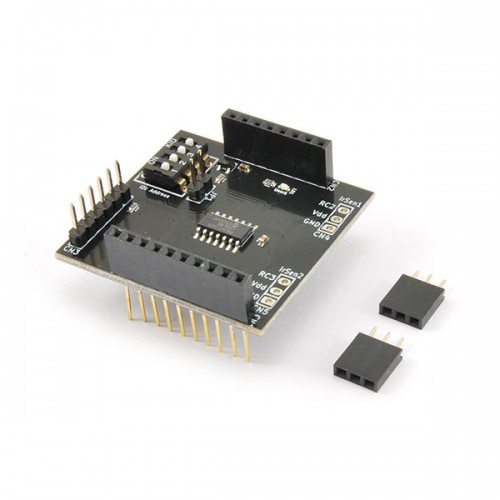
20_Output/30_Documentation/10_Datasheet/SB320_InfraredBoard/Images/SB320-2_main-500x500.jpg
