ffich/MercurySystem/20_Output/30_Documentation/10_Datasheet/SB320_InfraredBoard/Images/SB320_Front.png

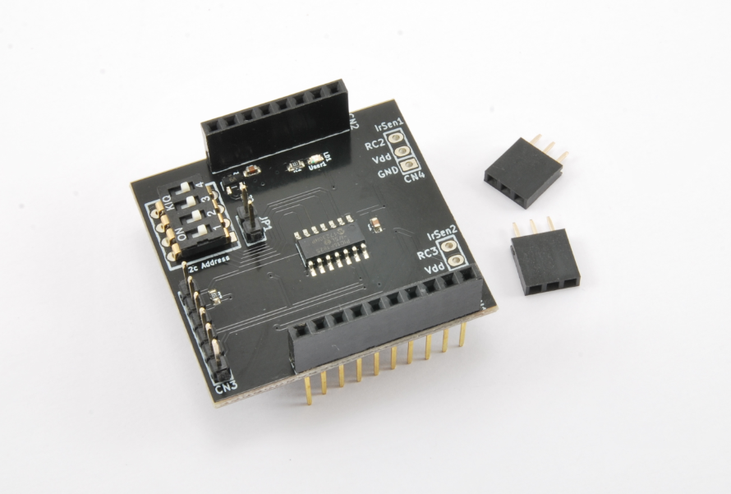
20_Output/30_Documentation/10_Datasheet/SB320_InfraredBoard/Images/SB320_Front.png
