ffich/MercurySystem/20_Output/30_Documentation/10_Datasheet/SB330_TemperatureBoard/Images/SB330_Front.jpg

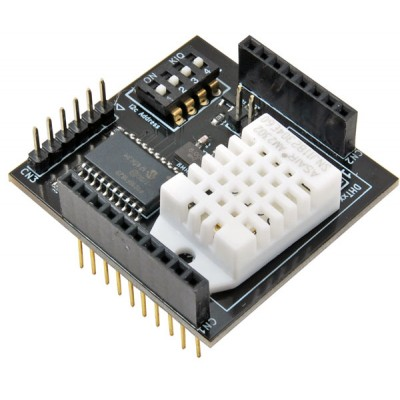
20_Output/30_Documentation/10_Datasheet/SB330_TemperatureBoard/Images/SB330_Front.jpg
