ffich/MercurySystem/20_Output/30_Documentation/10_Datasheet/SB810_ProtoBoardTypeA/Images/HW.png

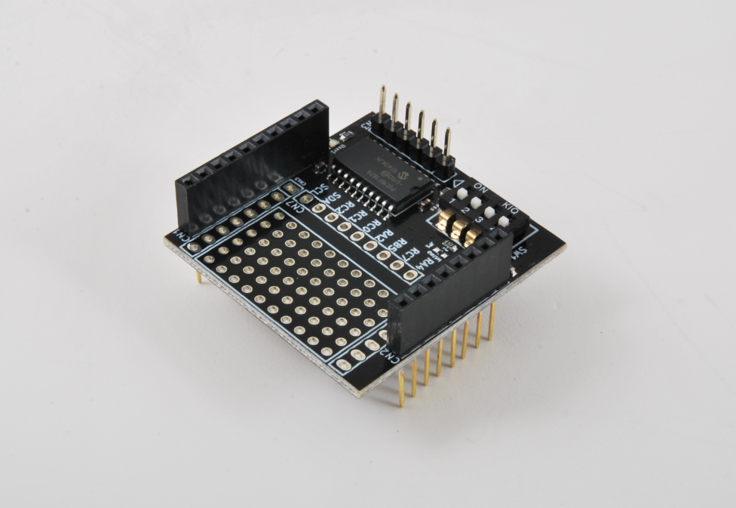
20_Output/30_Documentation/10_Datasheet/SB810_ProtoBoardTypeA/Images/HW.png
