ffich/MercurySystem/20_Output/30_Documentation/10_Datasheet/SB810_ProtoBoardTypeA/Images/SB810-3_main-500x500.jpg

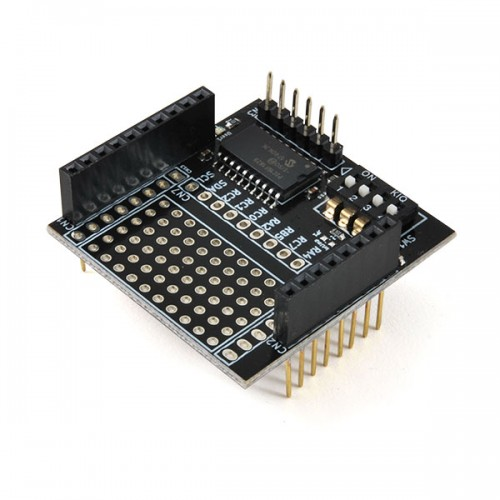
20_Output/30_Documentation/10_Datasheet/SB810_ProtoBoardTypeA/Images/SB810-3_main-500x500.jpg
