ffich/MercurySystem/20_Output/30_Documentation/20_UserManuals/10_GettingStartedGuide/Schematics/_Figure14.JPG

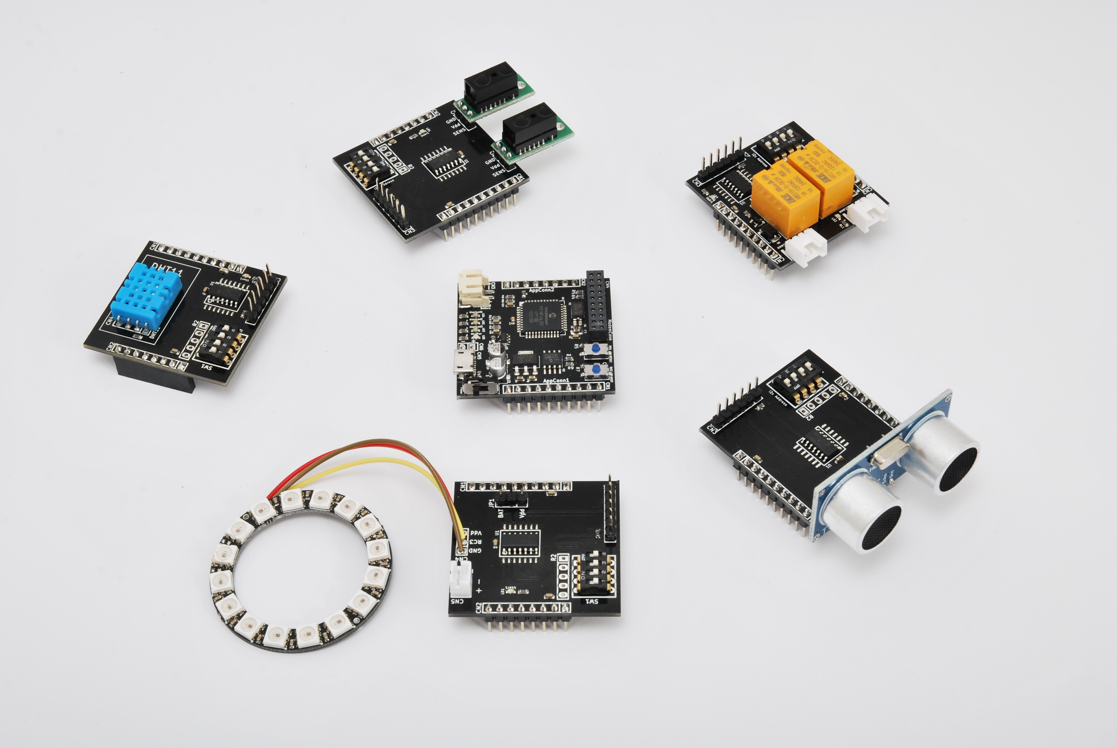
20_Output/30_Documentation/20_UserManuals/10_GettingStartedGuide/Schematics/_Figure14.JPG
