ffich/MercurySystem/20_Output/30_Documentation/20_UserManuals/10_GettingStartedGuide/Schematics/Figure27.png

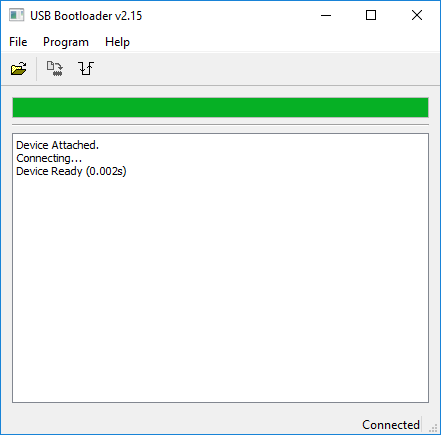
20_Output/30_Documentation/20_UserManuals/10_GettingStartedGuide/Schematics/Figure27.png
