ffich/MercurySystem/20_Output/30_Documentation/20_UserManuals/10_GettingStartedGuide/Schematics/Figure29.png

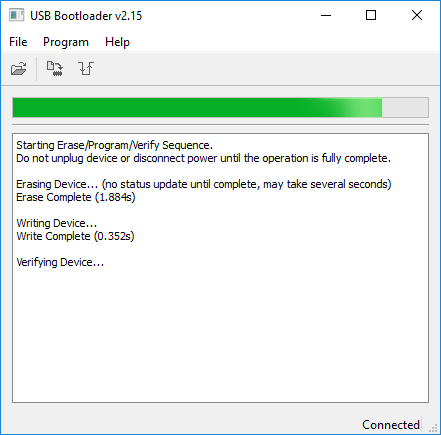
20_Output/30_Documentation/20_UserManuals/10_GettingStartedGuide/Schematics/Figure29.png
