ffich/MercurySystem/30_ProjectManagement/10_OPL/HwOpenPointList/_Report/Photo_001.jpg

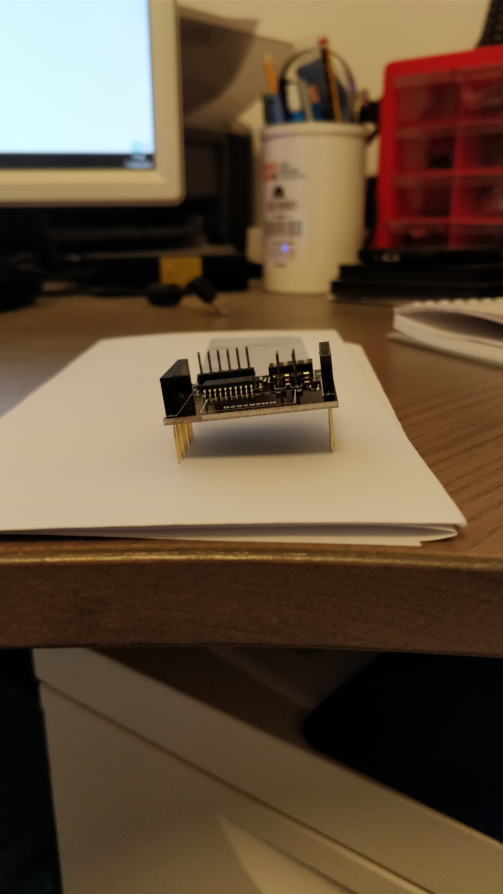
30_ProjectManagement/10_OPL/HwOpenPointList/_Report/Photo_001.jpg
