ffich/MercurySystem/20_Output/20_SwProjects/10_trunk/20_SlaveBoards/Boards/01_FwImages/RevisionHistory.xlsx

Sheet: App Revision History
App Revision History
Package Ver. | Affected Boards | Changes Description | Notes
1.0.0 | All | First release.
1.1.0 | All | Updated dip-switch managment for all boards.
1.2.0 | SB130 | SB130: added 3 new commands for simultaneous servo management (0x71, 0x72 and 0x73). Check board DS for more information.

Sheet: Fwk Revision History
Fwk Revision History
Fwk Ver. | Changes Description | Notes
1.0.0 | First release.
1.1.0 | Added StdS_SetI2cAddress func and fixed a bug on dip-switch read (now thhe dip-switch read is coherent with board silk-screen). Updated management of LED command.
1.2.0 | Improved I2C bus speed and performance.
