ffich/MercurySystem/(list of files, cad)

Other CAD files:
20_Output/20_SwProjects/10_trunk/10_BaseBoards/Bootloader/BootFwk/MercuryBoot_BB110.X/build/default/production/_ext/1254886142/VectorRemap.obj
20_Output/20_SwProjects/10_trunk/10_BaseBoards/Bootloader/BootFwk/MercuryBoot_BB110.X/dist/default/production/MercuryBoot_BB110.X.production.obj
20_Output/20_SwProjects/10_trunk/10_BaseBoards/Framework/FwkRelease/00_TestEnv/TestEnv.X/dist/Standalone/production/TestEnv.X.production.obj
20_Output/20_SwProjects/10_trunk/10_BaseBoards/Framework/MercuryFwk/MercuryFwk_BB110.X/dist/Bootloader/production/MercuryFwk_BB110.X.production.obj
20_Output/20_SwProjects/10_trunk/10_BaseBoards/Framework/MercuryFwk/MercuryFwk_BB110.X/dist/Merged/production/MercuryFwk_BB110.X.production.obj
20_Output/20_SwProjects/10_trunk/10_BaseBoards/Framework/MercuryFwk/MercuryFwk_BB110.X/dist/Standalone/production/MercuryFwk_BB110.X.production.obj
20_Output/20_SwProjects/10_trunk/20_SlaveBoards/Boards/EB210_ExpLcdAlphaBoard/EB210_ExpLcd.X/dist/default/production/EB210_ExpLcd.X.production.obj
20_Output/20_SwProjects/10_trunk/20_SlaveBoards/Boards/SB110_RelayBoard/SB110_Relay.X/dist/default/production/SB110_Relay.X.production.obj
20_Output/20_SwProjects/10_trunk/20_SlaveBoards/Boards/SB111_BigRelayBoard/SB111_BigRelay.X/dist/default/production/SB111_BigRelay.X.production.obj
20_Output/20_SwProjects/10_trunk/20_SlaveBoards/Boards/SB120_NeopixelBoard/SB120_Neopixel.X/dist/default/production/SB120_Neopixel.X.production.obj
20_Output/20_SwProjects/10_trunk/20_SlaveBoards/Boards/SB130_ServoBoard/SB130_Servo.X/dist/default/production/SB130_Servo.X.production.obj
20_Output/20_SwProjects/10_trunk/20_SlaveBoards/Boards/SB140_HsdBoard/SB140_Hsd.X/dist/default/production/SB140_Hsd.X.production.obj
20_Output/20_SwProjects/10_trunk/20_SlaveBoards/Boards/SB310_UltrasonicBoard/SB310_UsBoard.X/dist/default/production/SB310_UsBoard.X.production.obj
20_Output/20_SwProjects/10_trunk/20_SlaveBoards/Boards/SB320_InfraredBoard/SB320_Infrared.X/dist/default/production/SB320_Infrared.X.production.obj
20_Output/20_SwProjects/10_trunk/20_SlaveBoards/Boards/SB330_TempHumBoard/SB330_TempHum.X/dist/default/production/SB330_TempHum.X.production.obj
20_Output/20_SwProjects/10_trunk/20_SlaveBoards/Boards/SB810_GenIO/SB810_GenIO.X/dist/default/production/SB810_GenIO.X.production.obj
20_Output/20_SwProjects/10_trunk/20_SlaveBoards/Boards/SB810_ProtoModelABoard/Examples/Rover/SB810_Ex2Rover.X/dist/default/production/SB810_Ex2Rover.X.production.obj
20_Output/20_SwProjects/10_trunk/20_SlaveBoards/Boards/SB810_ProtoModelABoard/Examples/Temperature/SB810_Ex1Temp.X/dist/default/production/SB810_Ex1Temp.X.production.obj
20_Output/20_SwProjects/10_trunk/20_SlaveBoards/Boards/SB810_ProtoModelABoard/Template/SB810_ProtoA.X/dist/default/production/SB810_ProtoA.X.production.obj
20_Output/20_SwProjects/10_trunk/20_SlaveBoards/Boards/SB810_ProtoModelABoard/Examples/Rover/SB810_Ex2Rover.X/dist/default/production/SB810_Ex1Temp.X.production.obj
