ffich/MercurySystem/20_Output/30_Documentation/00_Template/MERCURY_HowTo_Template.docx

Mercury System

HOW TO

Subtitle…

Francesco Ficili

17/09/2017

Revision Log
Author | Date | Major | Minor | Description

Table of Content

# 1. Introduction

This manual...

Chapter: Introduction 3

How To: Template
