ffich/MercurySystem/(commit log)

2020-05-16 First Commit for MS repo
    [01_RevisionHistory.xlsx, EB210_ExpLcd.X.production.obj, MERCURY_Microcontroller_BoardCrossReference.xlsx, MERCURY_SYSTEM_HwOpenPointList.xlsx, MERCURY_SYSTEM_SwOpenPointList.xlsx, MercuryBoot_BB110.X.production.obj, MercuryFwk_BB110.X.production.obj, RevisionHistory.xlsx]
2020-05-16 Removed all post building scripts as they clash with network-mapped drives
    [EB210_ExpLcd.X.production.obj, SB130_Servo.X.production.obj]
